Spaceballs3000/FlyingRommy_V0.8/V0.9 - 32 Dip - ProbeBoard/ProbeBoard.kicad_pcb

## KiCad design V0.9 - 32 Dip - ProbeBoard/ProbeBoard.kicad_pcb (2025-02-19)

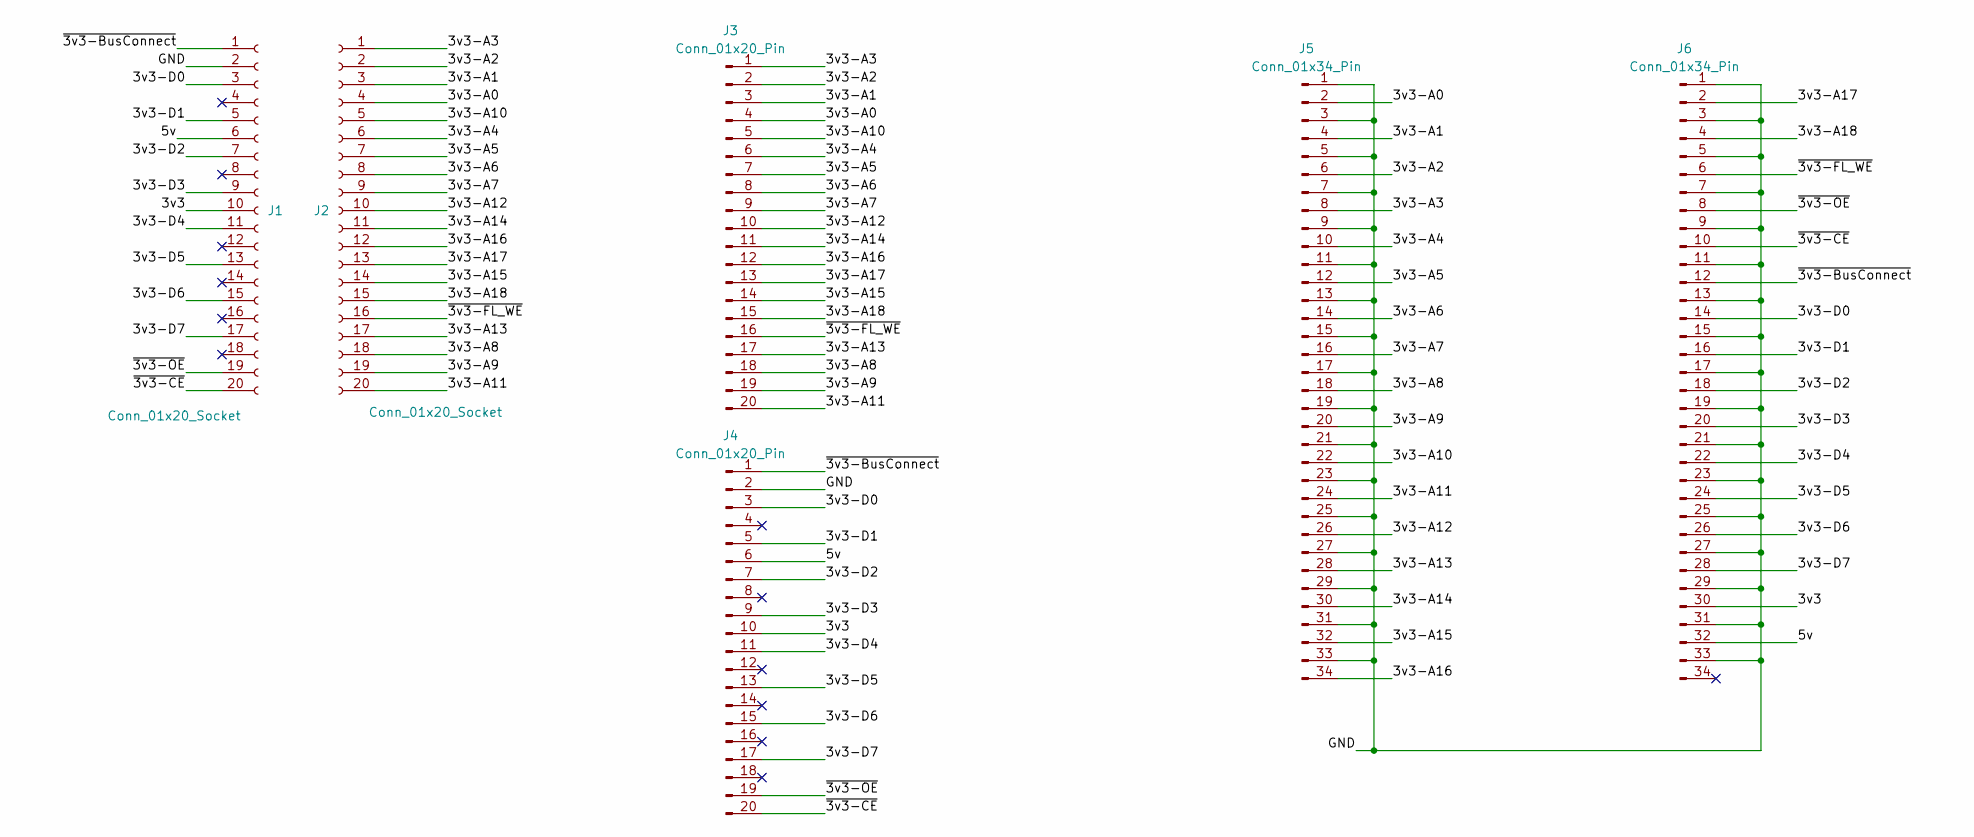
[picture p1: schematic ProbeBoard.kicad_sch, Flying Rommey]

Parts:
J1, J2: Conn_01x20_Socket; PinSocket_2x10_P1.00mm_Vertical_SMD
J3, J4: Conn_01x20_Pin; PinHeader_2x10_P1.00mm_Vertical_SMD
J5, J6: Conn_01x34_Pin; PinSocket_2x17_P2.54mm_Vertical

Connections:
/3v3: J1.10, J4.10, J6.30
/3v3-A0: J2.4, J3.4, J5.2
/3v3-A1: J2.3, J3.3, J5.4
/3v3-A2: J2.2, J3.2, J5.6
/3v3-A3: J2.1, J3.1, J5.8
/3v3-A4: J2.6, J3.6, J5.10
/3v3-A5: J2.7, J3.7, J5.12
/3v3-A6: J2.8, J3.8, J5.14
/3v3-A7: J2.9, J3.9, J5.16
/3v3-A8: J2.18, J3.18, J5.18
/3v3-A9: J2.19, J3.19, J5.20
/3v3-A10: J2.5, J3.5, J5.22
/3v3-A11: J2.20, J3.20, J5.24
/3v3-A12: J2.10, J3.10, J5.26
/3v3-A13: J2.17, J3.17, J5.28
/3v3-A14: J2.11, J3.11, J5.30
/3v3-A15: J2.14, J3.14, J5.32
/3v3-A16: J2.12, J3.12, J5.34
/3v3-A17: J2.13, J3.13, J6.2
/3v3-A18: J2.15, J3.15, J6.4
/3v3-D0: J1.3, J4.3, J6.14
/3v3-D1: J1.5, J4.5, J6.16
/3v3-D2: J1.7, J4.7, J6.18
/3v3-D3: J1.9, J4.9, J6.20
/3v3-D4: J1.11, J4.11, J6.22
/3v3-D5: J1.13, J4.13, J6.24
/3v3-D6: J1.15, J4.15, J6.26
/3v3-D7: J1.17, J4.17, J6.28
/5v: J1.6, J4.6, J6.32
/GND: J1.2, J4.2, J5.1, J5.3, J5.5, J5.7, J5.9, J5.11, J5.13, J5.15, J5.17, J5.19, J5.21, J5.23, J5.25, J5.27, J5.29, J5.31, J5.33, J6.1, J6.3, J6.5, J6.7, J6.9, J6.11, J6.13, J6.15, J6.17, J6.19, J6.21, J6.23, J6.25, J6.27, J6.29, J6.31, J6.33
/~3v3-BusConnect: J1.1, J4.1, J6.12
/~3v3-CE: J1.20, J4.20, J6.10
/~3v3-FL_WE: J2.16, J3.16, J6.6
/~3v3-OE: J1.19, J4.19, J6.8

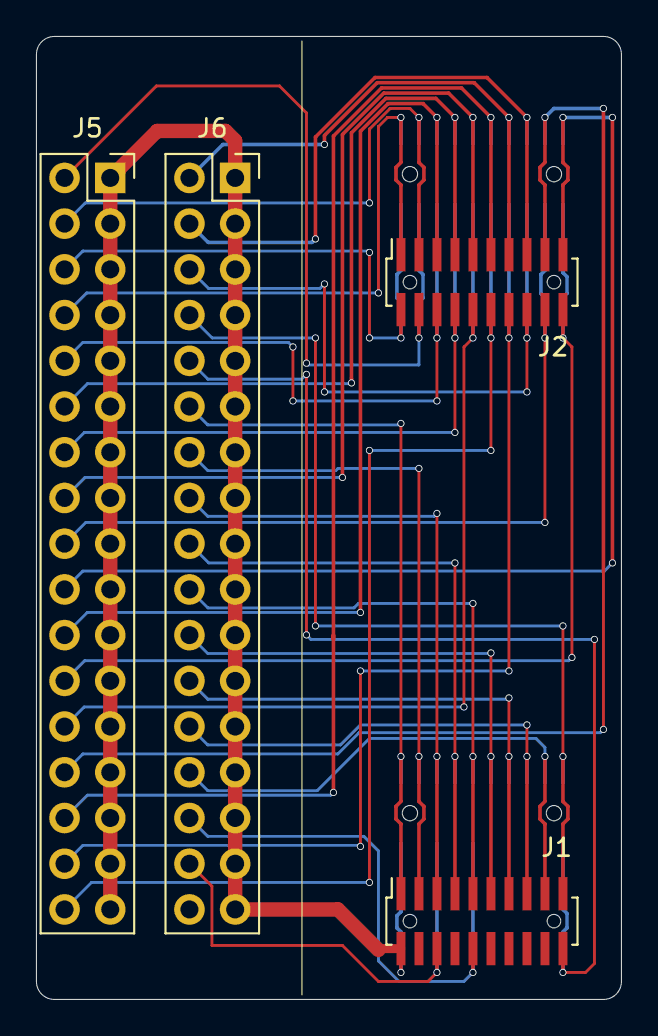
[picture p2: board ProbeBoard.kicad_pcb from above]

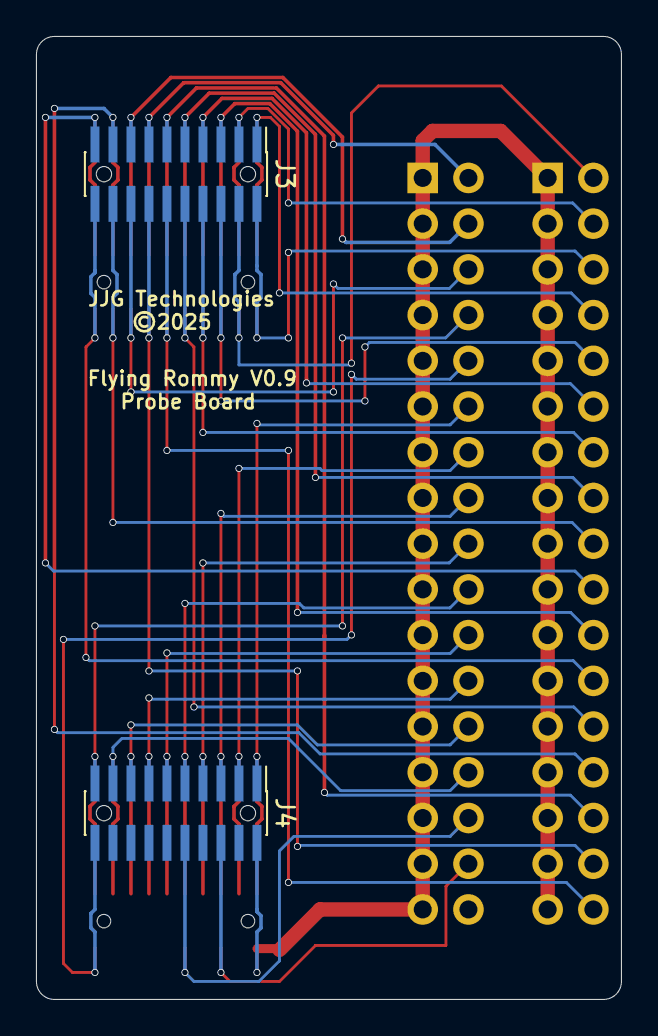
[picture p3: board ProbeBoard.kicad_pcb from below]

Board: 2 copper layers, 32.5 x 53.5 mm, 6 parts (2 on the bottom side), 34 nets.
