Spaceballs3000/FlyingRommy_V0.8/V0.9 - 32 Dip - Top Board/top.kicad_pcb

## KiCad design V0.9 - 32 Dip - Top Board/top.kicad_pcb (2025-02-19)

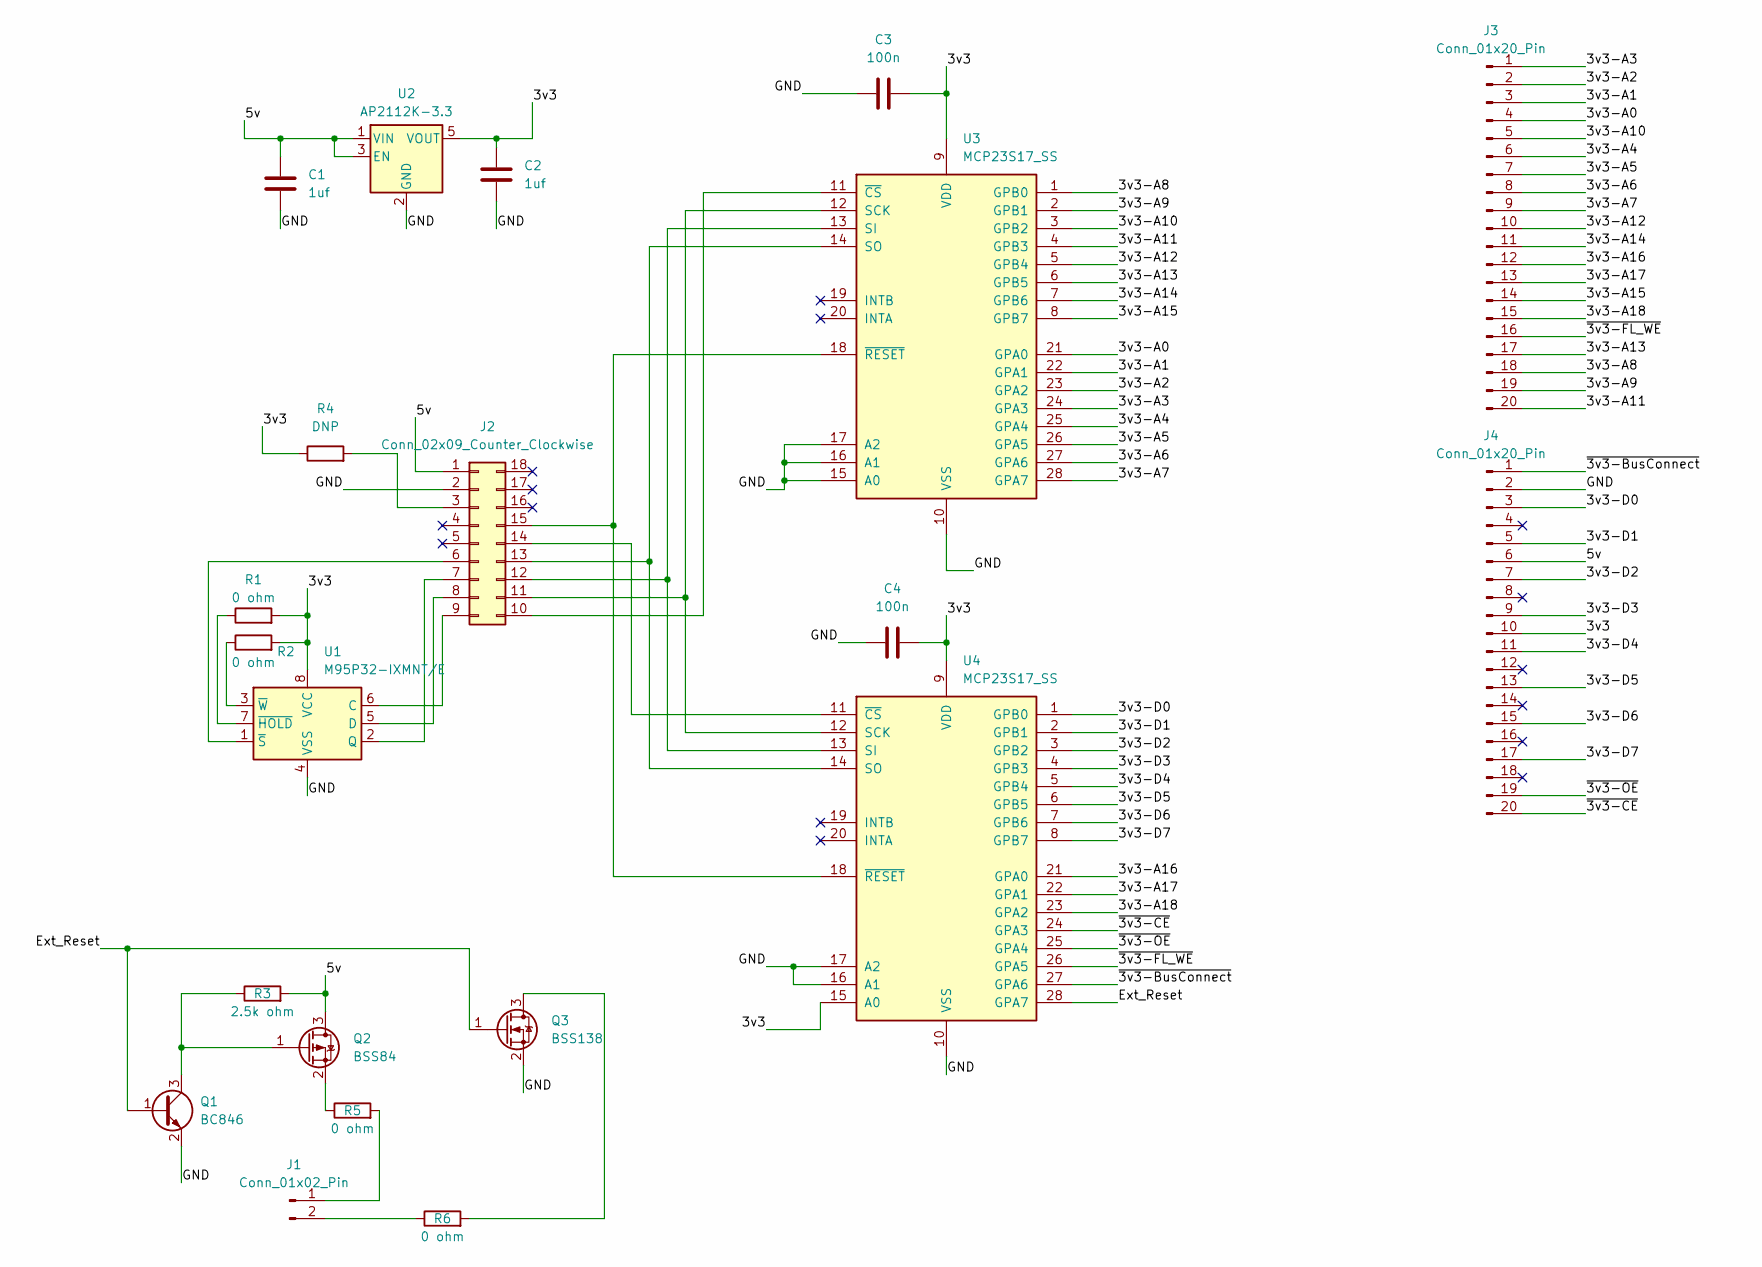
[picture p4: schematic top.kicad_sch, Flying Rommey]

Parts:
C1, C2: 1uf; C_0402_1005Metric
C3, C4: 100n; C_0603_1608Metric
J1: Conn_01x02_Pin; PinHeader_1x02_P2.54mm_Horizontal
J2: Conn_02x09_Counter_Clockwise; ESP32
J3, J4: Conn_01x20_Pin; PinHeader_2x10_P1.00mm_Vertical_SMD
Q1: BC846; SOT-23
Q2: BSS84; SOT-23
Q3: BSS138; SOT-23
R1, R2, R5, R6: 0 ohm; R_0402_1005Metric
R3: 2.5k ohm; R_0402_1005Metric
R4: DNP; R_0402_1005Metric
U1: M95P32-IXMNT/E; SOIC-8_3.9x4.9mm_P1.27mm
U2: AP2112K-3.3; SOT-23-5
U3, U4: MCP23S17_SS; SSOP-28_5.3x10.2mm_P0.65mm

Connections:
/3v3: C2.1, C3.1, C4.1, J4.10, R1.2, R2.2, R4.1, U1.8 (VCC), U2.5 (VOUT), U3.9 (VDD), U4.9 (VDD), U4.15 (A0)
/3v3-A0: J3.4, U3.21 (GPA0)
/3v3-A1: J3.3, U3.22 (GPA1)
/3v3-A2: J3.2, U3.23 (GPA2)
/3v3-A3: J3.1, U3.24 (GPA3)
/3v3-A4: J3.6, U3.25 (GPA4)
/3v3-A5: J3.7, U3.26 (GPA5)
/3v3-A6: J3.8, U3.27 (GPA6)
/3v3-A7: J3.9, U3.28 (GPA7)
/3v3-A8: J3.18, U3.1 (GPB0)
/3v3-A9: J3.19, U3.2 (GPB1)
/3v3-A10: J3.5, U3.3 (GPB2)
/3v3-A11: J3.20, U3.4 (GPB3)
/3v3-A12: J3.10, U3.5 (GPB4)
/3v3-A13: J3.17, U3.6 (GPB5)
/3v3-A14: J3.11, U3.7 (GPB6)
/3v3-A15: J3.14, U3.8 (GPB7)
/3v3-A16: J3.12, U4.21 (GPA0)
/3v3-A17: J3.13, U4.22 (GPA1)
/3v3-A18: J3.15, U4.23 (GPA2)
/3v3-D0: J4.3, U4.1 (GPB0)
/3v3-D1: J4.5, U4.2 (GPB1)
/3v3-D2: J4.7, U4.3 (GPB2)
/3v3-D3: J4.9, U4.4 (GPB3)
/3v3-D4: J4.11, U4.5 (GPB4)
/3v3-D5: J4.13, U4.6 (GPB5)
/3v3-D6: J4.15, U4.7 (GPB6)
/3v3-D7: J4.17, U4.8 (GPB7)
/5v: C1.1, J2.1, J4.6, Q2.3 (D), R3.2, U2.1 (VIN), U2.3 (EN)
/Ext_Reset: Q1.1 (B), Q3.1 (G), U4.28 (GPA7)
/GND: C1.2, C2.2, C3.2, C4.2, J2.2, J4.2, Q1.2 (E), Q3.2 (S), U1.4 (VSS), U2.2 (GND), U3.10 (VSS), U3.15 (A0), U3.16 (A1), U3.17 (A2), U4.10 (VSS), U4.16 (A1), U4.17 (A2)
/~3v3-BusConnect: J4.1, U4.27 (GPA6)
/~3v3-CE: J4.20, U4.24 (GPA3)
/~3v3-FL_WE: J3.16, U4.26 (GPA5)
/~3v3-OE: J4.19, U4.25 (GPA4)
unnamed: J1.1, R5.2
unnamed: J1.2, R6.1
unnamed: J2.3, R4.2
unnamed: J2.6, U1.1 (~S)
unnamed: J2.7, U1.2 (Q)
unnamed: J2.8, U1.5 (D)
unnamed: J2.9, U1.6 (C)
unnamed: J2.10, U3.11 (~CS)
unnamed: J2.11, U3.12 (SCK), U4.12 (SCK)
unnamed: J2.12, U3.13 (SI), U4.13 (SI)
unnamed: J2.13, U3.14 (SO), U4.14 (SO)
unnamed: J2.14, U4.11 (~CS)
unnamed: J2.15, U3.18 (~RESET), U4.18 (~RESET)
unnamed: Q1.3 (C), Q2.1 (G), R3.1
unnamed: Q2.2 (S), R5.1
unnamed: Q3.3 (D), R6.2
unnamed: R1.1, U1.7 (~HOLD)
unnamed: R2.1, U1.3 (~W)

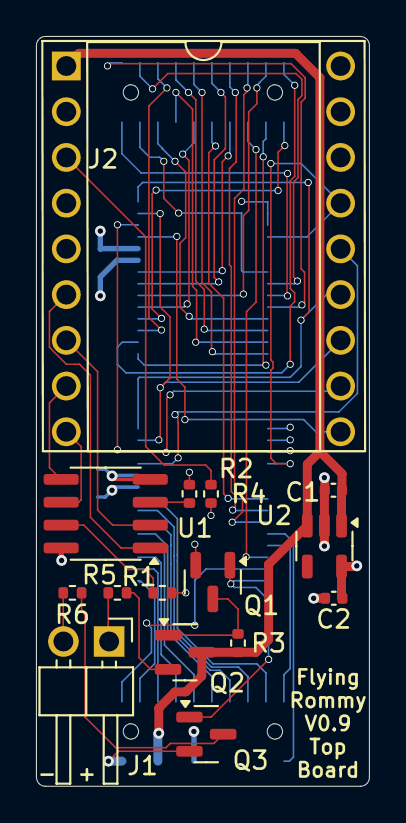
[picture p5: board top.kicad_pcb from above]

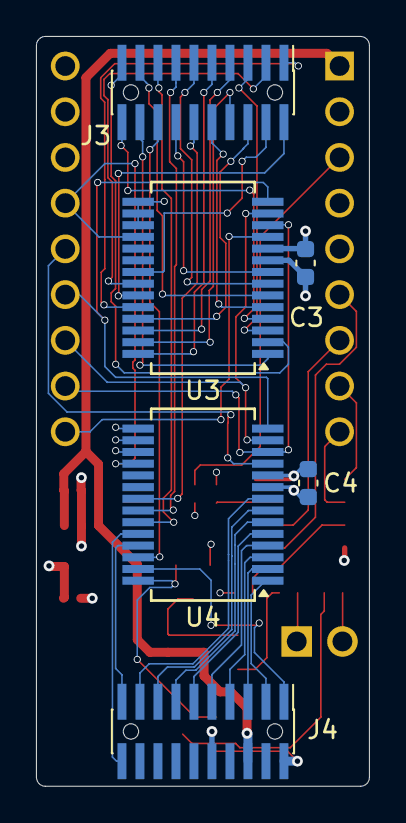
[picture p6: board top.kicad_pcb from below]

Board: 4 copper layers, 18.5 x 41.7 mm, 21 parts (6 on the bottom side), 53 nets.
