Spaceballs3000/FlyingRommy_V0.8/V0.9 - 32 Dip - Bottom Board/Base.kicad_pcb

## KiCad design V0.9 - 32 Dip - Bottom Board/Base.kicad_pcb (2025-02-19)

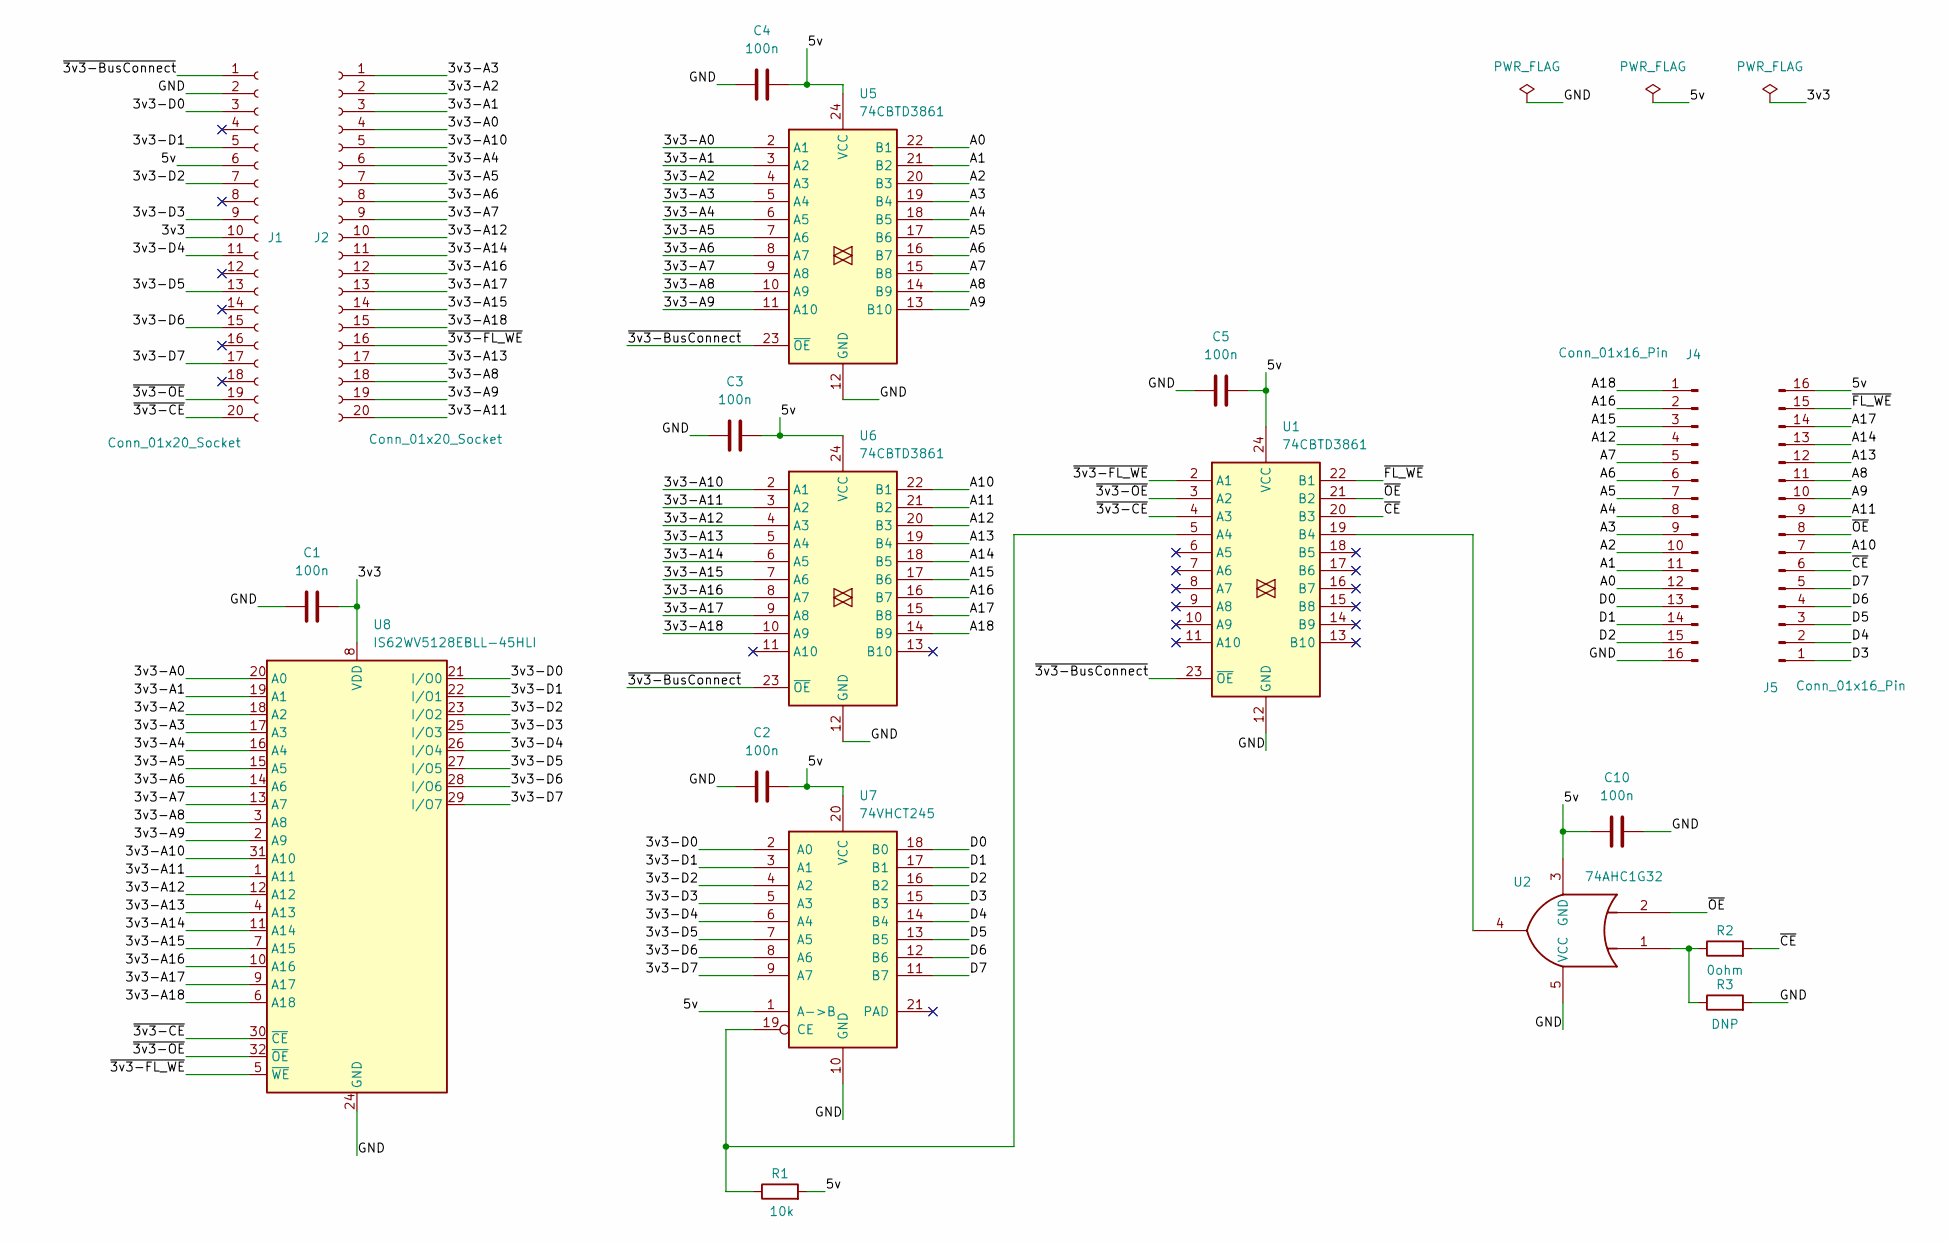
[picture p7: schematic Base.kicad_sch, Flying Rommey]

Parts:
C1, C2, C3, C4, C5, C10: 100n; C_0603_1608Metric
J1, J2: Conn_01x20_Socket; PinSocket_2x10_P1.00mm_Vertical_SMD
J4, J5: Conn_01x16_Pin; PinHeader_1x16_P2.54mm_Vertical
R1: 10k; R_0402_1005Metric
R2: 0ohm; R_0402_1005Metric
R3: DNP; R_0402_1005Metric
U1, U5, U6: 74CBTD3861; SSOP-24_3.9x8.7mm_P0.635mm
U2: 74AHC1G32; SOT-353_SC-70-5
U7: 74VHCT245; DHVQFN-20-1EP_2.5x4.5mm_P0.5mm_EP1x3mm
U8: IS62WV5128EBLL-45HLI; TSOP-I-32_11.8x8mm_P0.5mm

Connections:
/3v3: C1.1, J1.10, U8.8 (VDD)
/3v3-A0: J2.4, U5.2 (A1), U8.20 (A0)
/3v3-A1: J2.3, U5.3 (A2), U8.19 (A1)
/3v3-A2: J2.2, U5.4 (A3), U8.18 (A2)
/3v3-A3: J2.1, U5.5 (A4), U8.17 (A3)
/3v3-A4: J2.6, U5.6 (A5), U8.16 (A4)
/3v3-A5: J2.7, U5.7 (A6), U8.15 (A5)
/3v3-A6: J2.8, U5.8 (A7), U8.14 (A6)
/3v3-A7: J2.9, U5.9 (A8), U8.13 (A7)
/3v3-A8: J2.18, U5.10 (A9), U8.3 (A8)
/3v3-A9: J2.19, U5.11 (A10), U8.2 (A9)
/3v3-A10: J2.5, U6.2 (A1), U8.31 (A10)
/3v3-A11: J2.20, U6.3 (A2), U8.1 (A11)
/3v3-A12: J2.10, U6.4 (A3), U8.12 (A12)
/3v3-A13: J2.17, U6.5 (A4), U8.4 (A13)
/3v3-A14: J2.11, U6.6 (A5), U8.11 (A14)
/3v3-A15: J2.14, U6.7 (A6), U8.7 (A15)
/3v3-A16: J2.12, U6.8 (A7), U8.10 (A16)
/3v3-A17: J2.13, U6.9 (A8), U8.9 (A17)
/3v3-A18: J2.15, U6.10 (A9), U8.6 (A18)
/3v3-D0: J1.3, U7.2 (A0), U8.21 (I/O0)
/3v3-D1: J1.5, U7.3 (A1), U8.22 (I/O1)
/3v3-D2: J1.7, U7.4 (A2), U8.23 (I/O2)
/3v3-D3: J1.9, U7.5 (A3), U8.25 (I/O3)
/3v3-D4: J1.11, U7.6 (A4), U8.26 (I/O4)
/3v3-D5: J1.13, U7.7 (A5), U8.27 (I/O5)
/3v3-D6: J1.15, U7.8 (A6), U8.28 (I/O6)
/3v3-D7: J1.17, U7.9 (A7), U8.29 (I/O7)
/5v: C2.1, C3.1, C4.1, C5.1, C10.2, J1.6, J5.16, R1.2, U1.24 (VCC), U2.3 (GND), U5.24 (VCC), U6.24 (VCC), U7.1 (A->B), U7.20 (VCC)
/A0: J4.12, U5.22 (B1)
/A1: J4.11, U5.21 (B2)
/A2: J4.10, U5.20 (B3)
/A3: J4.9, U5.19 (B4)
/A4: J4.8, U5.18 (B5)
/A5: J4.7, U5.17 (B6)
/A6: J4.6, U5.16 (B7)
/A7: J4.5, U5.15 (B8)
/A8: J5.11, U5.14 (B9)
/A9: J5.10, U5.13 (B10)
/A10: J5.7, U6.22 (B1)
/A11: J5.9, U6.21 (B2)
/A12: J4.4, U6.20 (B3)
/A13: J5.12, U6.19 (B4)
/A14: J5.13, U6.18 (B5)
/A15: J4.3, U6.17 (B6)
/A16: J4.2, U6.16 (B7)
/A17: J5.14, U6.15 (B8)
/A18: J4.1, U6.14 (B9)
/D0: J4.13, U7.18 (B0)
/D1: J4.14, U7.17 (B1)
/D2: J4.15, U7.16 (B2)
/D3: J5.1, U7.15 (B3)
/D4: J5.2, U7.14 (B4)
/D5: J5.3, U7.13 (B5)
/D6: J5.4, U7.12 (B6)
/D7: J5.5, U7.11 (B7)
/GND: C1.2, C2.2, C3.2, C4.2, C5.2, C10.1, J1.2, J4.16, R3.2, U1.12 (GND), U2.5 (VCC), U5.12 (GND), U6.12 (GND), U7.10 (GND), U8.24 (GND)
/~3v3-BusConnect: J1.1, U1.23 (~OE), U5.23 (~OE), U6.23 (~OE)
/~3v3-CE: J1.20, U1.4 (A3), U8.30 (~CE)
/~3v3-FL_WE: J2.16, U1.2 (A1), U8.5 (~WE)
/~3v3-OE: J1.19, U1.3 (A2), U8.32 (~OE)
/~CE: J5.6, R2.2, U1.20 (B3)
/~FL_WE: J5.15, U1.22 (B1)
/~OE: J5.8, U1.21 (B2), U2.2
unnamed: R2.1, R3.1, U2.1
unnamed: R1.1, U1.5 (A4), U7.19 (CE)
unnamed: U1.19 (B4), U2.4

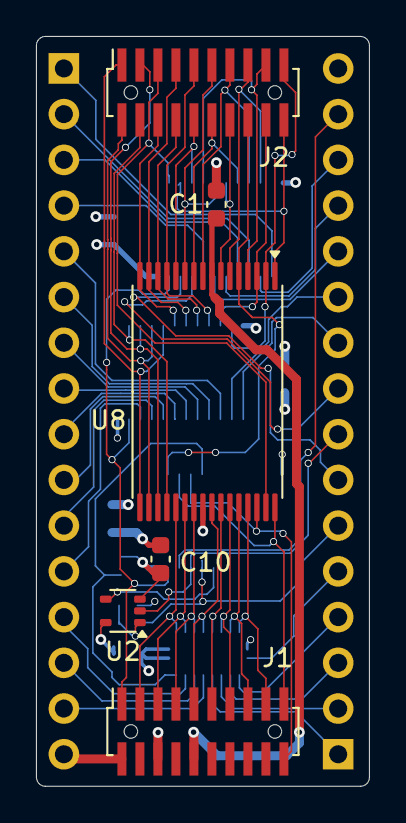
[picture p8: board Base.kicad_pcb from above]

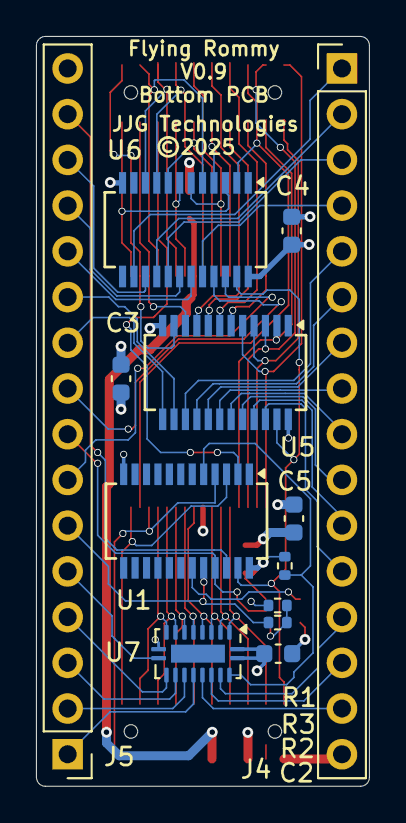
[picture p9: board Base.kicad_pcb from below]

Board: 4 copper layers, 18.5 x 41.7 mm, 19 parts (13 on the bottom side), 67 nets.
