Spaceballs3000/FlyingRommy_V0.8/(threads)

Thread 1 (2025-04-09):

Create a storage device for config

billsargent, 2025-04-09:
I recommend being able to plug this into a PC and it show up as a storage device to configure IP and wireless information.

Spaceballs3000, 2025-04-14:
That would sound useful, do you know if there an ESP32 example I can use?
