Spaceballs3000/FlyingRommy_V0.8/(commit log)

2025-02-13 Updated Bottom PCB
    [Base.kicad_pcb, Base.kicad_sch]
2025-02-14 added mounting holes to 0.1 headers
    [Base.kicad_pcb, Base.kicad_sch]
2025-02-15 Logic OR fix
    [Base.kicad_pcb, Base.kicad_sch, top.kicad_pcb, top.kicad_sch]
2025-02-15 Removed Buffer updated Or logic.
    [Base.kicad_pcb, Base.kicad_sch]
2025-02-17 Add Probe PCB, Latest Top/Bottom PCBs
    [Base.kicad_pcb, ProbeBoard.kicad_pcb, ProbeBoard.kicad_sch, top.kicad_pcb]
2025-02-19 Made V0.9 Larger VIAs for cheaper boards.
    [Base.kicad_pcb, Base.kicad_sch, ProbeBoard.kicad_pcb, ProbeBoard.kicad_sch, top.kicad_pcb, top.kicad_sch]
