Spaceballs3000/FlyingRommy_V0.8/(notices)

Notices in the files:
V0.9 - 32 Dip - Bottom Board/Base.kicad_pcb:
©2025
